ChaceAshcraft/470robotLab/mse430_head/README.md

# mse430
Design and software for a small educational robot developed for CS 470 (Artificial Intelligence) at BYU.
