ChaceAshcraft/470robotLab/mse430_head/pcb/Gerber/README.txt

Part: RobotBooster

Layers: 2
Size: max board dimension 3.6" x 3.6", routing 3" x 1.8"
Thickness: 0.062 in.
Material: FR4
Surface finish: HASL
Outer copper: 1 oz
Solder mask color: black
Solder mask type: LPI
Solder mask sides: both
Silkscreen color: white
Silkscreen sides: top
Stackup: NA

Outline/dimension: robot_booster.dim
Top copper: robot_booster.cmp
Bottom copper: robot_booster.sol
Top mask: robot_booster.stc
Bottom mask: robot_booster.sts
Top silk: robot_booster.plc
Bottom silk: NA
Drill: robot_booster.drd

Eagle also left a .gpi and a .dri file, those can be ignored.

Note: I marked "No" on "Route and Retain" because I understood that to mean 
that it would be in a panel with tabs, which I don't want. I do want the out 
edge of the board cut out, however, so if I misunderstood that and need to 
change something, please email me asap.
