ChaceAshcraft/470robotLab/(list of files, cad)

Other CAD files:
mse430_head/chassis/chassis.dwg
