ChaceAshcraft/470robotLab/mse430_head/chassis/chassis.pdf

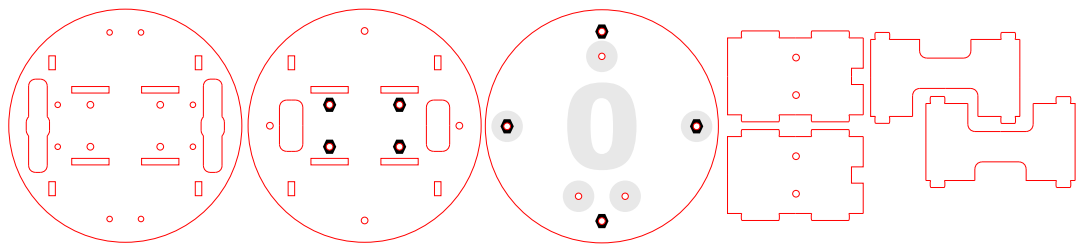
[picture p1: page 1]
