ChaceAshcraft/470robotLab/mse430_head/pcb/robot_booster.brd

## EAGLE design mse430_head/pcb/robot_booster.brd (2017-09-27)

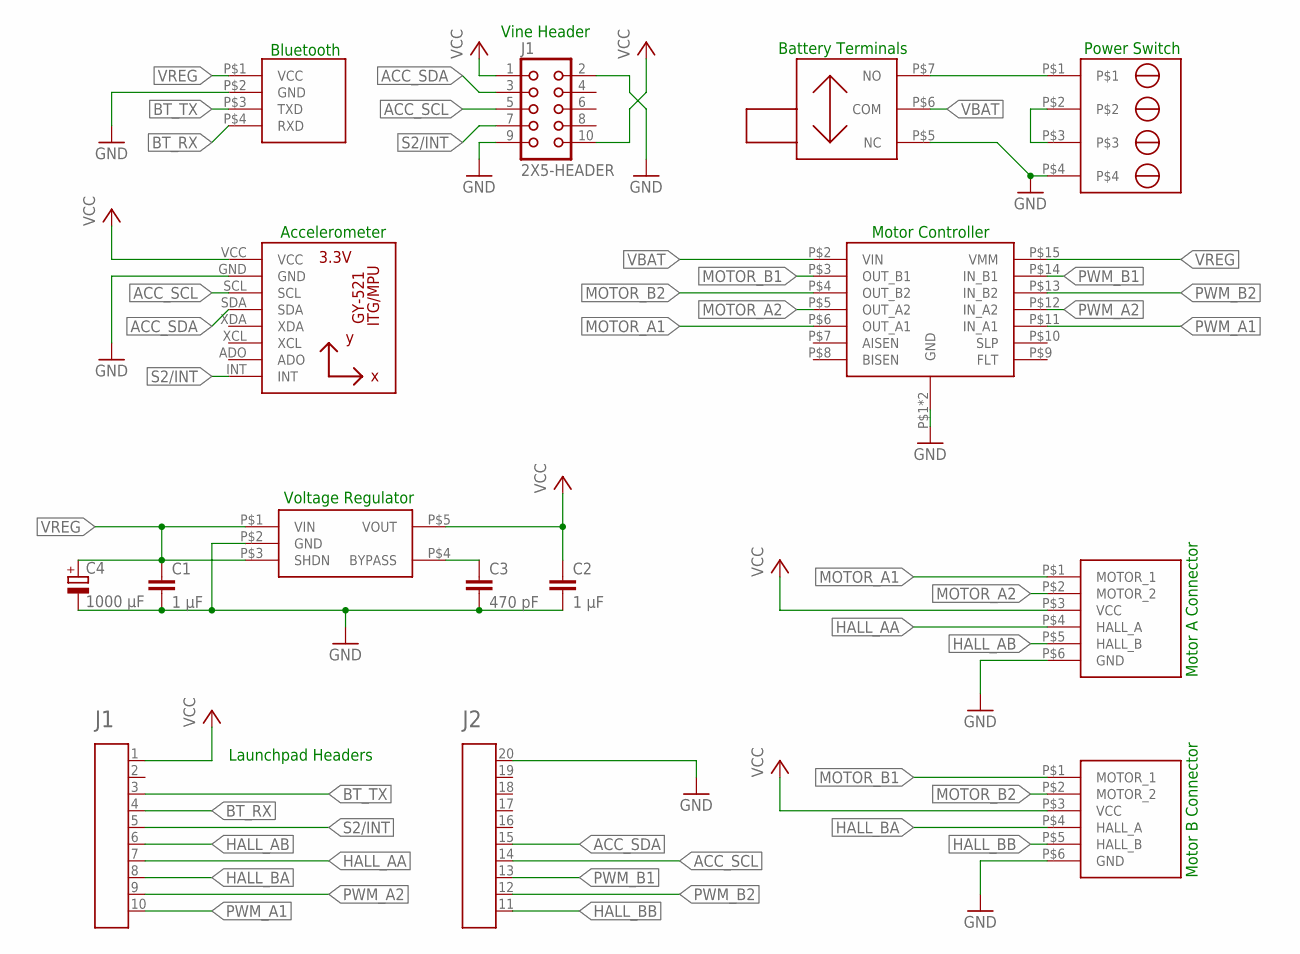
[picture p2: schematic robot_booster.sch]

Parts:
C1, C2: 1 µF; C0603
C3: 470 pF; C0603
C4: 1000 µF; E5-5
J1: 2X5-HEADER; 2X5_1.27MM_SMALL
U1: GY-521-HEADER
U$1: HEADER2X10-BOOSTERPACK; 2X10-BOOSTERPACK
U$2, U$3: POLOLU-MICROMETAL-ENCODER; 2MM-1X6-JST
U$4: POLOLU-DRV8833; HEADER-2X8-4W
U$5: TC1015; 5-PIN-SOT-23
U$6: HC06-RIGHT-ANGLE-HEADER; HEADER-4X1-RIGHT-ANGLE
U$7: 1X4-SCREW-TERMINAL-BLOCK-OSTTE040104; 1X04-SCREW-TERMINAL-BLOCK-OSTTE040104
U$8: SWITCH-EG1224; SWITCH-EG122-RIGHT-ANGLE

Connections:
ACC_SCL: J1.5, U1.SCL, U$1.14
ACC_SDA: J1.3, U1.SDA, U$1.15
BT_RX: U$1.4, U$6.P$4 (RXD)
BT_TX: U$1.3, U$6.P$3 (TXD)
GND: C1.2, C2.2, C3.2, C4.-, J1.2, J1.9, U1.GND, U$1.20, U$2.P$6 (GND), U$3.P$6 (GND), U$4.P$1 (GND), U$4.P$16 (GND), U$5.P$2 (GND), U$6.P$2 (GND), U$7.P$4, U$8.P$5 (NC)
HALL_AA: U$1.7, U$2.P$4 (HALL_A)
HALL_AB: U$1.6, U$2.P$5 (HALL_B)
HALL_BA: U$1.8, U$3.P$4 (HALL_A)
HALL_BB: U$1.11, U$3.P$5 (HALL_B)
MOTOR_A1: U$2.P$1 (MOTOR_1), U$4.P$6 (OUT_A1)
MOTOR_A2: U$2.P$2 (MOTOR_2), U$4.P$5 (OUT_A2)
MOTOR_B1: U$3.P$1 (MOTOR_1), U$4.P$3 (OUT_B1)
MOTOR_B2: U$3.P$2 (MOTOR_2), U$4.P$4 (OUT_B2)
unnamed: U$7.P$2, U$7.P$3
unnamed: U$7.P$1, U$8.P$7 (NO)
unnamed: C3.1, U$5.P$4 (BYPASS)
PWM_A1: U$1.10, U$4.P$11 (IN_A1)
PWM_A2: U$1.9, U$4.P$12 (IN_A2)
PWM_B1: U$1.13, U$4.P$14 (IN_B1)
PWM_B2: U$1.12, U$4.P$13 (IN_B2)
S2/INT: J1.7, U1.INT, U$1.5
VBAT: U$4.P$2 (VIN), U$8.P$6 (COM)
VCC: C2.1, J1.1, J1.10, U1.VCC, U$1.1, U$2.P$3 (VCC), U$3.P$3 (VCC), U$5.P$5 (VOUT)
VREG: C1.1, C4.+, U$4.P$15 (VMM), U$5.P$1 (VIN), U$5.P$3 (SHDN), U$6.P$1 (VCC)

Notes on the sheet:
Accelerometer
Motor Controller
Motor A Connector
Motor B Connector
Voltage Regulator
Power Switch
Battery Terminals
Launchpad Headers
Bluetooth
Vine Header

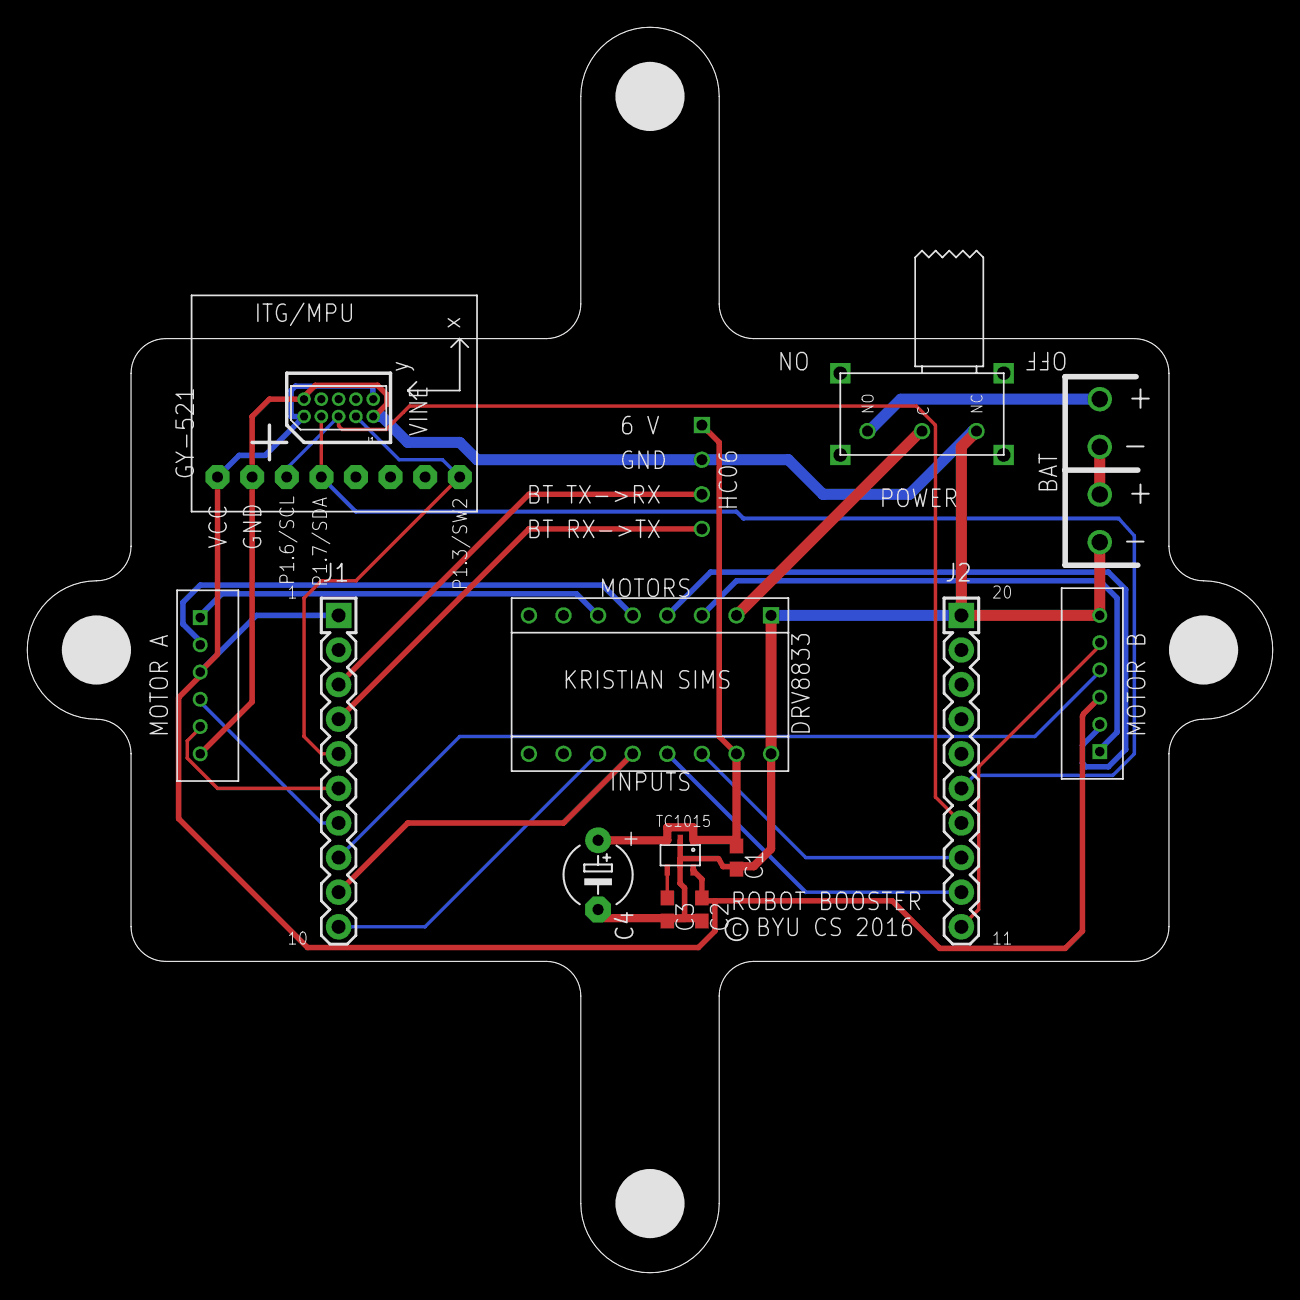
[picture p3: board robot_booster.brd from above]

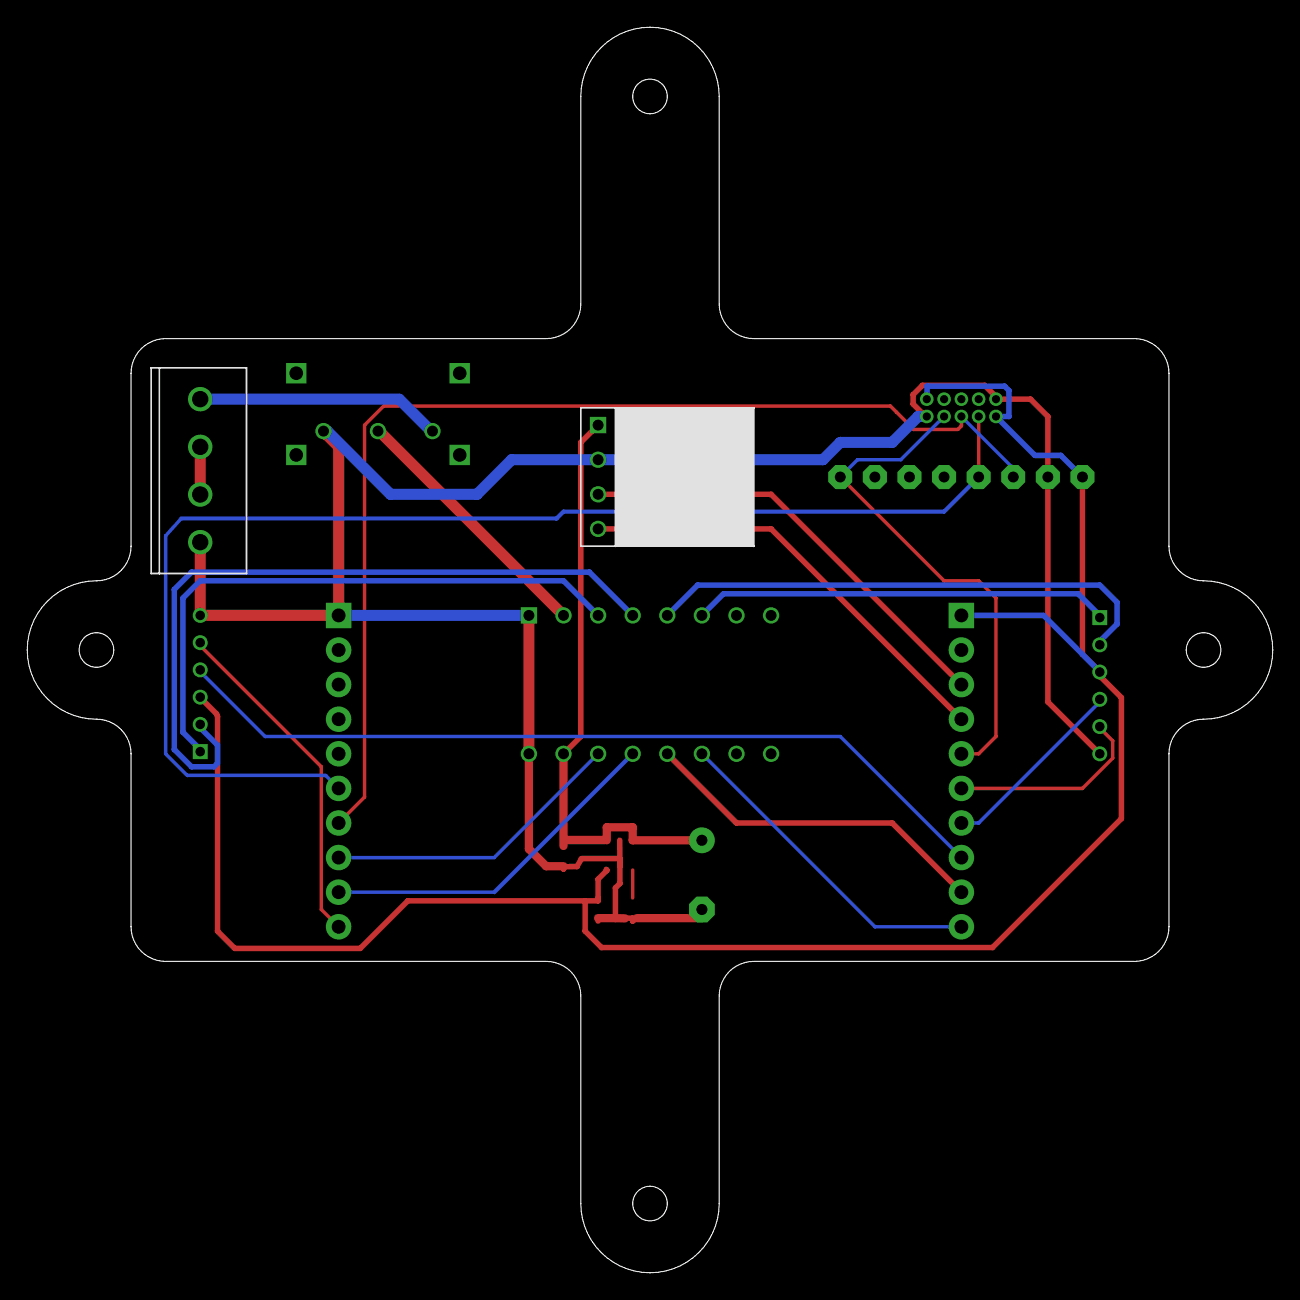
[picture p4: board robot_booster.brd from below]

Board: 2 copper layers, 91.4 x 91.4 mm, 14 parts (2 on the bottom side), 24 nets.
