ChaceAshcraft/470robotLab/mse430_head/robot/motor.h

/*
 * motor.h
 *
 *  Created on: Apr 13, 2016
 *      Author: Kristian Sims
 */

#ifndef MOTOR_H_
#define MOTOR_H_

// Public variables
extern volatile long motor_a_count;
extern volatile long motor_b_count;
extern volatile long motor_a_rate;
extern volatile long motor_b_rate;
extern int motor_a_power;
extern int motor_b_power;

// Public function prototypes
int motor_init();
void motor_a_set_power(int power);
void motor_b_set_power(int power);
void motor_update_rates();

#endif /* MOTOR_H_ */
