ChaceAshcraft/470robotLab/(commit log)

2017-09-27 added starter code
    [chassis.dwg, robot_booster.brd, robot_booster.sch]
2017-09-28 got new updated files
    [chassis.dwg, robot_booster.brd, robot_booster.sch]
2017-10-20 tried out A*
    [chassis.dwg, robot_booster.brd, robot_booster.sch]
